romsreu/LAH/twin/assets/images/cupboard/right_door.png

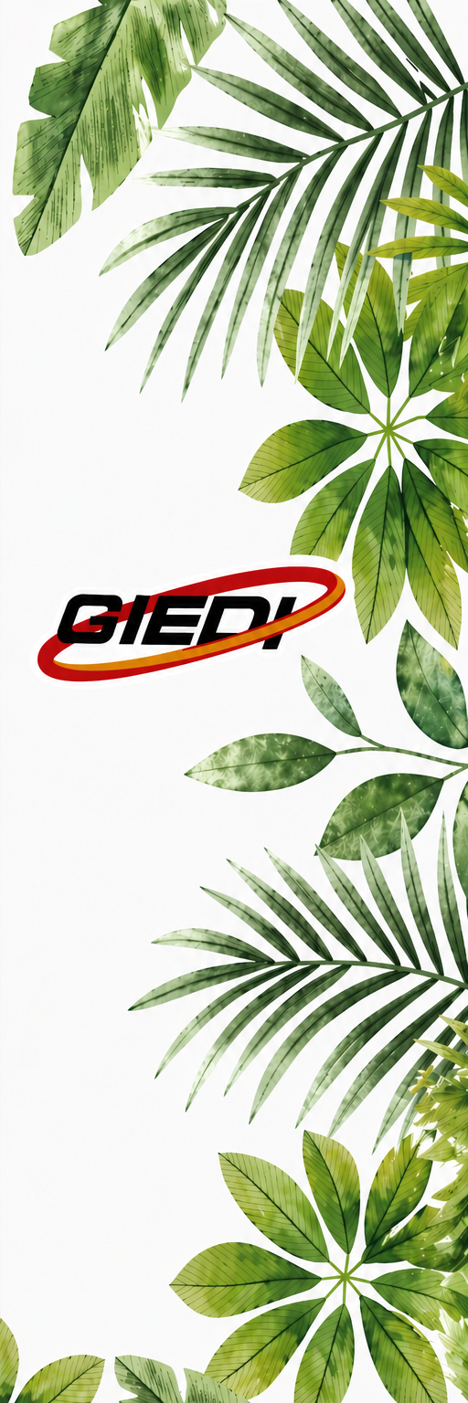
twin/assets/images/cupboard/right_door.png
