romsreu/LAH/twin/assets/images/cupboard/left_door.png

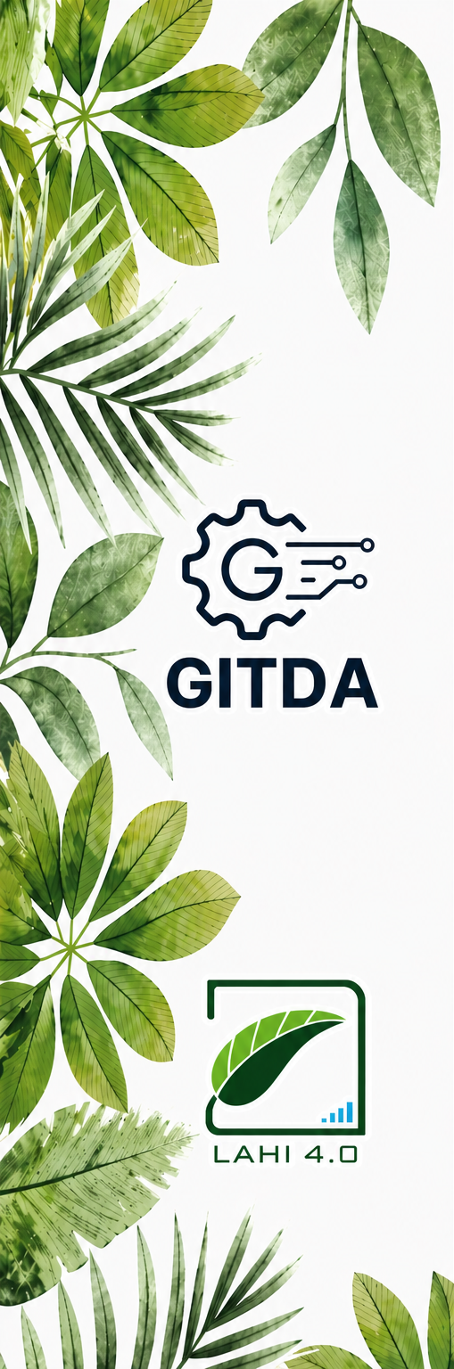
twin/assets/images/cupboard/left_door.png
