romsreu/LAH/twin/README.md

banner
