romsreu/LAH/twin/assets/images/textures/metal2/Metal049C_1K-JPG_Color.jpg

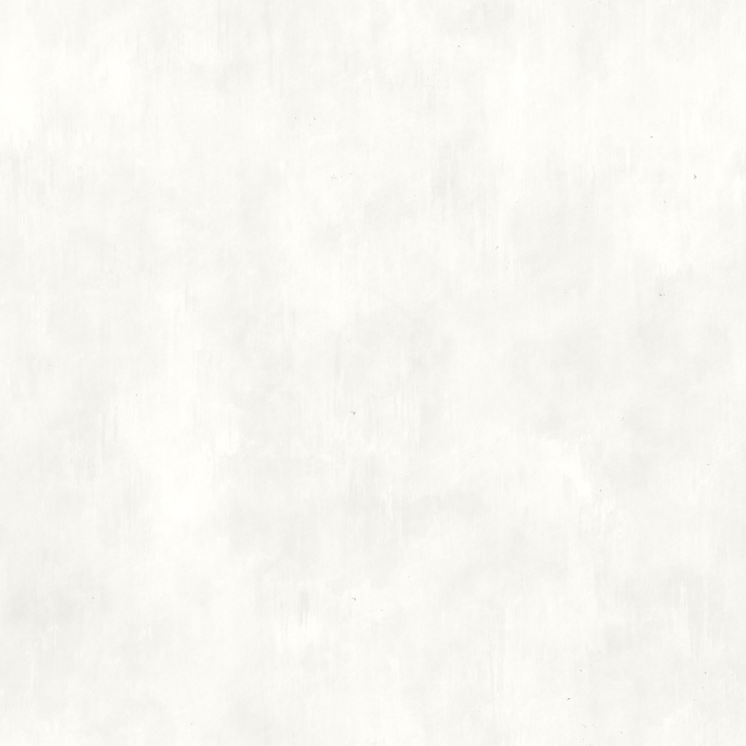
twin/assets/images/textures/metal2/Metal049C_1K-JPG_Color.jpg
