romsreu/LAH/twin/referencia1.jpeg

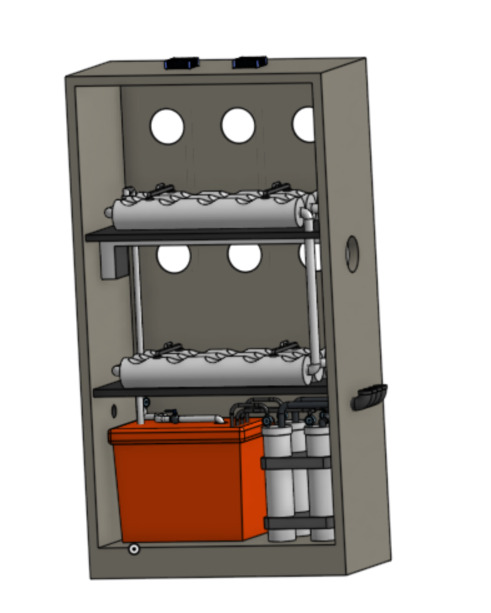
twin/referencia1.jpeg
