romsreu/LAH/twin/referencia2.jpeg

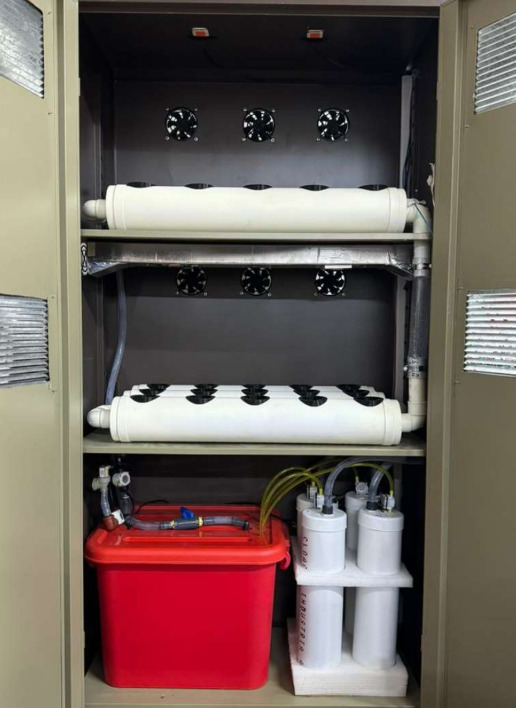
twin/referencia2.jpeg
