romsreu/LAH/twin/referencia3.jpeg

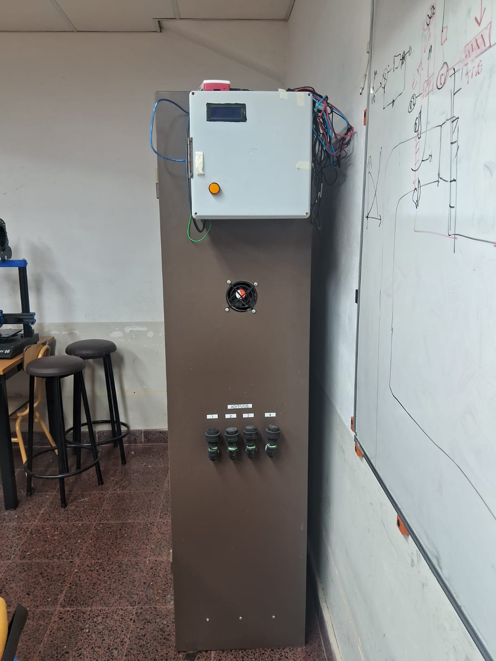
twin/referencia3.jpeg
