romsreu/LAH/twin/assets/images/textures/metal3/VLMU5200-serie-140.SLDPRT

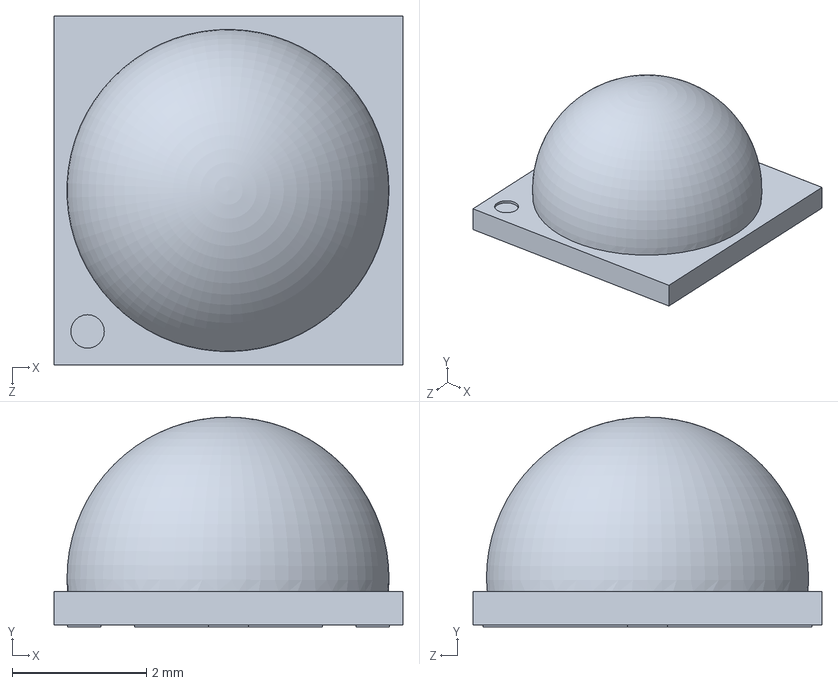
[picture p80: CAD file, 2026-09-16]
twin/assets/images/textures/metal3/VLMU5200-serie-140.SLDPRT
5.20 x 3.12 x 5.20 mm
