romsreu/LAH/twin/scenes/3d/lights/lights.obj

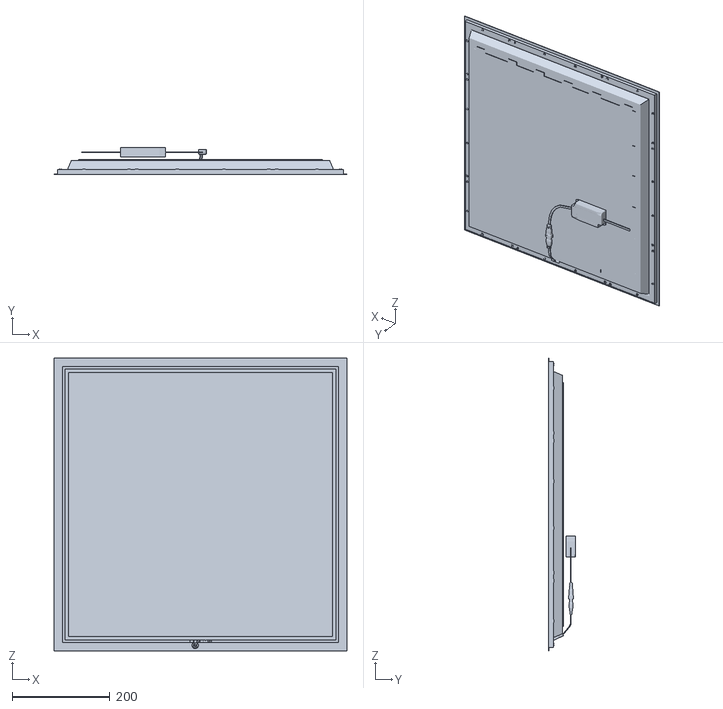
[picture p81: CAD file, 2026-09-16]
twin/scenes/3d/lights/lights.obj
600.0 x 56.3 x 600.0
