romsreu/LAH/(list of files, cad)

Other CAD files:
twin/VLMU5200-serie-140.STEP
