romsreu/LAH/firmware/tests/CAL_pH/calibracion_pH.ods

pH — Calibración de Sonda (buffers 4 y 7)
LAHI 4.0 — Módulo PH-4502C
Buffer | pH real (patrón) | Voltaje medido (V)
Buffer pH 7 (neutro) | 7.01 | 0.000
Buffer pH 4 (ácido) | 4.01 | 0.000
Resultados de la calibración
Pendiente (slope) | #DIV/0!
Offset | #DIV/0!
Fórmula final | #DIV/0!
Verificación (debe coincidir con el pH real del buffer)
pH calculado — Buffer 7 | #DIV/0! | #DIV/0!
pH calculado — Buffer 4 | #DIV/0! | #DIV/0!
 |  |  | Escala de referencia de pH (ácido → neutro → básico)
 |  |  | 0 | 1 | 2 | 3 | 4 | 5 | 6 | 7 | 8 | 9 | 10 | 11 | 12 | 13 | 14
