romsreu/LAH/(commit log)

2026-09-16 chore: initial commit
    [VLMU5200-serie-140.SLDPRT, VLMU5200-serie-140.STEP, calibracion_pH.ods, export_presets.cfg, lights.obj]
2026-09-18 feat: add Raspberry Pi bridge from Arduino to InfluxDB Cloud
2026-09-18 docs: revise README for clarity and remove diagram
    Updated the README to clarify the data flow and removed the diagram.
2026-09-24 fix(firmware): force decimal notation for float fields in serial JSON
    [json_serial.cpp]
2026-09-24 fix(tools): write simulated data to LAH-sim bucket
2026-09-24 feat(edge): sync bridge from Raspberry, add log rotation and discard DS18B20 -127
2026-09-24 fix: rename real data bucket to LAH-real
2026-09-29 docs: Update README with image and remove ASCII diagram
    Removed ASCII diagram and added an image for data flow architecture.
2026-09-29 feat(twin): add branded web loading screen and embed simulation in visualizer
    [export_presets.cfg]
2026-09-29 feat(twin): technical look, control panel and optimized web export
    [export_presets.cfg]
