romsreu/LAH/(notices)

Notices in the files:
twin/scenes/3d/lights/lights.obj:
3ds Max Wavefront OBJ Exporter v0.99 - (c)2007 guruware
